photonicfusion/PhotoniClock/Documentation/html/images/display.png

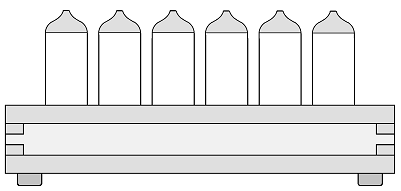
Documentation/html/images/display.png
