photonicfusion/PhotoniClock/Documentation/html/images/PhotoniClock.png

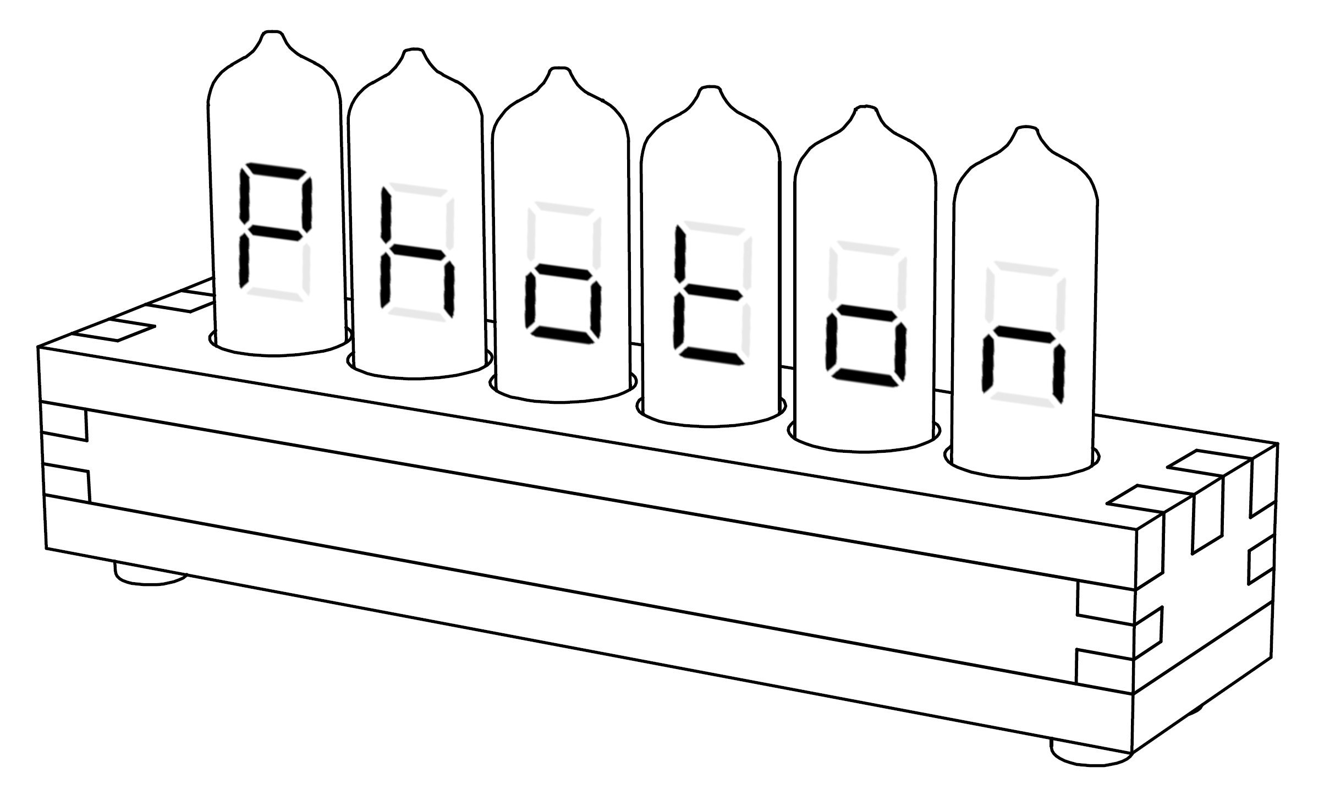
Documentation/html/images/PhotoniClock.png
