photonicfusion/PhotoniClock/Documentation/PhotoniClock User Manual.pdf

# PhotoniClock User Manual


## Last Revised: 25 September 2018

# Table of Contents

1. Introducon
2. Features
3. Specificaons
4. Safety
5. Background
6. Operaon
6.1. Info Menu
6.2. Disable Display
6.3. Main Menu
6.4. Alarms
6.5. Display Brightness
6.6. Configuraon
6.7. Display Blanking
6.8. Set Time
6.9. Set Date
6.10. LED Effect
6.11. Music
6.12. Timer (Countdown)
7. Open-Source Hardware & Soware
7.1. Flashing Firmware
7.2. Custom Music
8. Revision History
9. Contact Informaon
10. Warranty

# INTRODUCTION

Congratulaons on choosing the PhotoniClock! It is a fusion of past and present, combining the elegance of a bygone era with the technology of today. We hope it finds a place in your life and piques the curiosity of all who encounter it.

Thank you,

The PhotonicFusion Team

# FEATURES

• Handcraed Padauk wood finished with a protecve natural oil.
• Accurate mekeeping via temperature-compensated crystal oscillator (TCXO). • RTC backup for +24hr power-loss me retenon (unlike your microwave).
• Three alarms with individual day of the week sengs.
• Configurable Date/Time formats and Power On/Off schedule.
• Ambient light sensing adapts display brightness to environment.
• Music database of 40+ songs.
• RGB LEDs provide colorful and unique lighng effects.
• Input voltage protecon from Over/Under/Reverse condions. • Includes standard FTDI header for programming via Arduino IDE. • Open-source soware and hardware.

# SPECIFICATIONS

Item | Specificaon
Input voltage range | +9V to +15V (*see note)
Typical input power | 4.2W
Under/Over-voltage protecon | ±32V
Over-current protecon | PTC Thermistor, 750mA trip current
Typical clock dri | Less than 10s per month
Operang temperature | 0°C to 50°C (32°F to 122°F)
Storage Temperature | -20°C to 60°C (-44°F to 140°F)

*Note: Use the provided power adapter or use a power supply rated for a current of at least 1A to ensure the PhotoniClock's over-current protecon mechanism can funcon properly.

# SAFETY

The PhotoniClock has basic protecon against over-current, over-voltage, and under-voltage condions, however care should be taken to prevent these condions from occurring. Be careful not to touch or short any exposed circuit while powered, as doing so may permanently damage the clock. Do not modify the circuit in any way. Use the provided power adapter or a power supply rated for a current of at least 1A to ensure the PhotoniClock's over-current protecon mechanism can funcon properly.

# BACKGROUND

The PhotoniClock ulizes Vacuum Fluorescent Display (VFD) tubes, a specialized type of vacuum tube developed throughout the early 1960s into the late 1980s designed specifically for alphanumeric indicaon. The VFD tubes selected for this clock are called IV-11. They are a medium-sized, discrete, seven-segment display manufactured originally for the USSR by the Reflector plant in Saratov, Russia from the 1980s unl 1993.

VFD tubes operate under the same principals of vacuum tubes. Each tube contains two very thin wires called filaments through which an electric current is passed. If you view the PhotoniClock in a dark environment and reduce the display brightness, you may see the two filaments faintly glowing. Each of the VFD tube's seven segments are electrically connected to a circuit which can toggle a high voltage on/off, +56V in this parcular design. When this high voltage is applied to a segment, negavely charged electrons emied from the filament are magnecally aracted towards the posively charged segment. Upon striking the segment, the electrons are absorbed by a phosphor coang which re-emits the energy in the form of visible light, specifically a characterisc blue-green light associated with VFDs.

# OPERATION

On the backside of the PhotoniClock is a combined rotary encoder and buon knob. This knob is the sole method of input for controlling the PhotoniClock. When the PhotoniClock first turns on, it enters Clock Mode (displaying the current me). The Info Menu and the Main Menu are only accessible when in Clock Mode. All menus eventually meout and return to Clock Mode. Sengs will not be modified if a meout occurs before compleon.

Time is presented in this documentaon using the format HH:MM:SS where HH=Hours, MM=Minutes, and SS=Seconds.

## INFO MENU

Access the Info Menu by pressing the knob when in Clock Mode. The menu hierarchy is shown below. Advance to subsequent menu items by pressing the knob again.

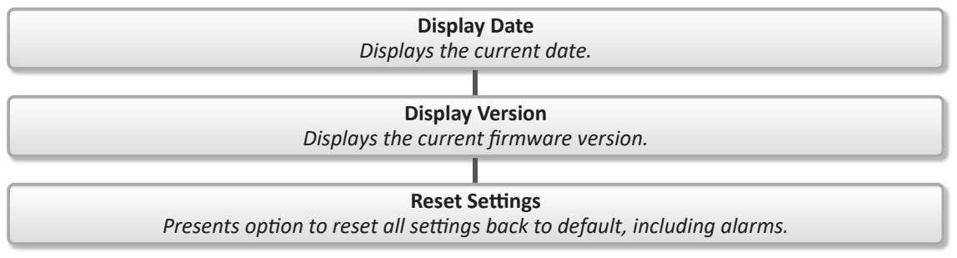
[picture p3: figure]
Display Date Displays the current date.; Display Version Displays the current firmware version.; Reset Sengs

Presents opon to reset all sengs back to default, including alarms.

## DISABLE DISPLAY

The display can be turned off by pressing and holding the knob for at least 3 seconds when entering the Info Menu. The display will remain off unl user input is received, an alarm occurs, or the display blanking Power-On me matches the current me.

## MAIN MENU

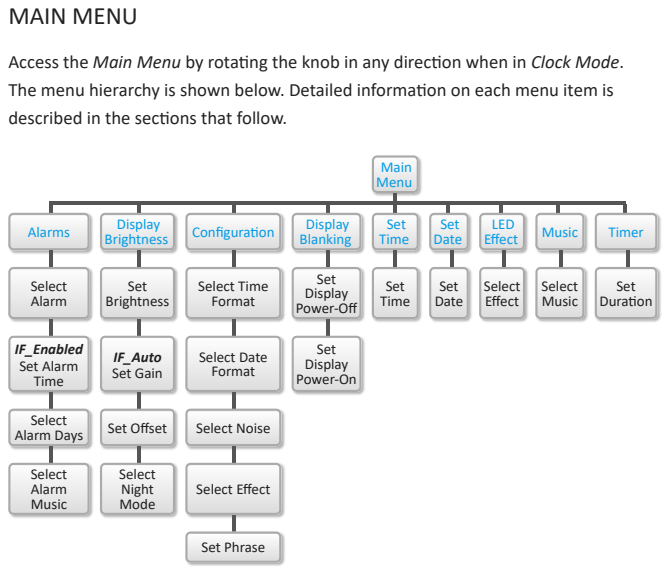
[picture p4: page 7]
Main Menu; Alarms; Display Brightness; Configuraon; Display Blanking; Set Time; Set Date; LED; Effect; Music; Timer; Select Alarm; Set Brightness; Select Time Format; Set Display Power-Off; Select Effect; Select Music; Set Duraon; IF_Enabled Set Alarm Time; IF_Auto Set Gain; Select Date Format; Set Display Power-On; Select Alarm Days; Set Offset; Select Noise; Select Alarm Music; Select Night Mode; Set Phrase

Access the Main Menu by rotang the knob in any direcon when in Clock Mode.
The menu hierarchy is shown below. Detailed informaon on each menu item is
described in the secons that follow.

## ALARMS

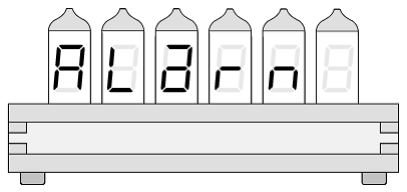
[picture p5: figure]

The PhotoniClock features three individual alarms. Each alarm may be set for a specific me and day(s) of the week for which it shall be acve. The decimal of the lemost VFD tube indicates whether an alarm is armed within the next 24 hours. If an alarm is armed, the decimal will be illuminated.

When an alarm me and day matches the current me and day, an alarm event will occur. An alarm event will cause the display to turn on (if it was previously off) and the alarm music selecon to sound. The alarm will sound for at least 2 minutes or unl interrupted. Any user input will interrupt the alarm.

Seng an alarm:

1. Select Alarm from the Main Menu.
2. Select one of the three alarms A1, A2, or A3 from the list. The current state of the alarm is displayed beside it as On if at least one day of the week is enabled, otherwise Off will be displayed.
3. Select Enable to connue configuring the alarm, or Dsable to disable the alarm and exit.
4. | Set | Set the me of day when the alarm should sound.
5. The day selecon menu will cycle through all days of the week. You may skip to any day by rotang the knob. Select a day to choose whether the alarm should be armed ( Enable ) or disarmed ( Dsable ) for that day. The menu will automacally advance to the next day aer a selecon is made.
Exit the menu by selecng ‑Done‑ | from the menu.
6. | Audio | Select the music that will play when the alarm sounds.

## DISPLAY BRIGHTNESS

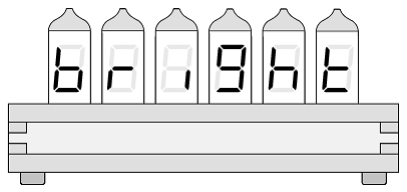
[picture p6: figure]

The PhotoniClock has 8 brightness levels for the display. In addion, there in an Auto Mode that will adjust the display brightness according to the ambient lighng condions. Aer selecng Auto Mode, there in an opon to enable Night Mode which will use minimum display brightness and turn off the LEDs when dark ambient condions are present. This provides an acceptable brightness level to avoid being bothersome at night.

Seng the display brightness:

1. Select Bright | from the Main Menu.
2. Select one of the 8 brightness sengs or select | Auto | to enable automac
brightness. If Auto Mode is selected, follow the remaining steps.
3. | Gain | Select the sensor gain. This value adjusts the sensivity of the
light sensor.
4. Offset Select the sensor offset. This value adjusts the minimum value measured by the light sensor.
5. | Night | Select whether to enable ( Enable ) or disable ( Dsable )
Night Mode. When enabled and dark ambient condions are present, minimum display brightness will be used and the LEDs will be disabled.

## CONFIGURATION

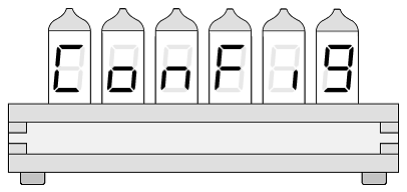
[picture p7: figure]

The PhotoniClock is customizable and can be configured to user preference. Configuraon sengs include me and date format, knob noise generaon, display effects, and custom phrase.

Configuring the PhotoniClock:

1. Select Config from the Main Menu.
2. | Hour | Select the hour format to be 12-hour ( 12 hr | ) or 24-hour
( 24 hr | ) mode.
3. | Date | Select the date format to be Y-M-D ( Y‑M‑D | ), M-D-Y ( M‑D‑Y | ),
or D-M-Y ( D‑M‑Y | ) where D=Day, M=Month, and Y=Year.
4. | Noise | Select whether an audible blip is enabled ( Enable ) or
disabled ( Dsable ) when the rotary encoder knob is turned.
5. Effect Select whether an effect should be displayed during normal clock display. Opons include:
• None No effect will be displayed.
• Spiral A spiral effect will be displayed when the seconds reach 0. • Date The current date will be displayed when the seconds reach 30. • Phrase The user configured phrase will be displayed when the seconds reach 30.
6. Phrase Input a custom phrase to display during alarms and display
| effects.

## DISPLAY BLANKING

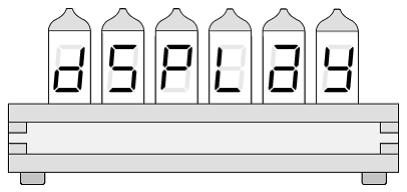
[picture p8: figure]

The PhotoniClock includes a display blanking feature which allows for scheduled mes when the display should turn off/on. This feature is useful if you want to turn off the clock at night (alternavely see Night Mode), or prolong the lifespan of the VFD tubes.

Seng the display blanking schedule:

1. Select Dsplay | from the Main Menu.
2. | P-Off | Input the me in HH:MM when the display should power-off.
3. | P-On | Input the me in HH:MM when the display should power-on.

Disable display blanking:

To disable display blanking, simply set the P-Off and P-On mes to be equal. This prevents display blanking from occurring.

## SET TIME

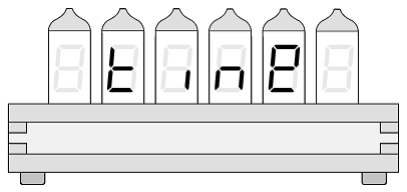
[picture p9: figure]

The PhotoniClock ulizes an RTC with a temperature-compensated crystal oscillator (TCXO). This parcular RTC has a very low clock dri, specified less than 10s per month. In addion, an on-board supercapacitor maintains RTC me and date during a power-loss event for over 24 hours.

Seng the me:

1. Select | Time | from the Main Menu.
2. | Time | Input the me in HH:MM:SS to set the clock.
3. | Cycle | If the Hour Format is configured to 12-hour mode, there will be
an addional selecon asking for current cycle. Choose between AM
( | AM | ) and PM ( | PM | ). The decimal of the rightmost VFD tube indicates
the current cycle. It will illuminate when the cycle is PM.

## SET DATE

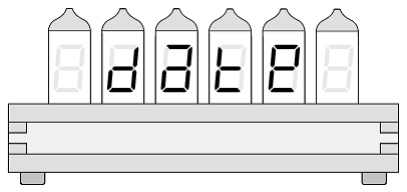
[picture p10: figure]

The PhotoniClock RTC automacally adjusts for leap years and accepts dates from 01-January-2000, to 31-December-2099.

Seng the date:

1. Select | Date | from the Main Menu.
2. | Date | Input the date to set the clock. The format used will be Y-M-D,
M-D-Y, or D-M-Y where D=Day, M=Month, and Y=Year depending on which Date Format is configured.

## LED EFFECT

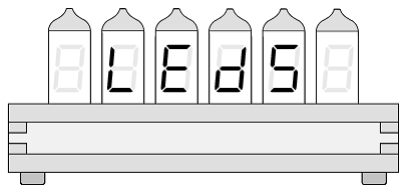
[picture p11: figure]

Beneath each VFD tube is an RGB LED. This array of LEDs can be configured to display effects listed in the descripon below. LED brightness is automacally adjusted to match the display brightness. In the event that Night Mode is triggered, the LEDs will be disabled.

Seng the LED effect:

1. Select | LEDs | from the Main Menu.
2. Effect Select the LED effect desired. Opons include: • Static Stac color choice.
• Pulse | Slow pulsing color choice.
• Fire | Fire effect of color choice.
• 1982 | Knight Rider effect of color choice.
• Pong | Color-changing bounce.
• Fade | Slow color-changing transions.
• Rainbo LEDs cycle through hue in unison.
• CShift LEDs cycle through hue in sequence.
• Ghost | Slow color orbs.
• Drops | Colors drop and combine every second.
• Digit | Hours, Minutes, Seconds translate to colors.
• Tetris Colors "fall" and collect.
• Cycle Cycle through all effects except Stac and Disable. • Dsable No effect will be displayed.

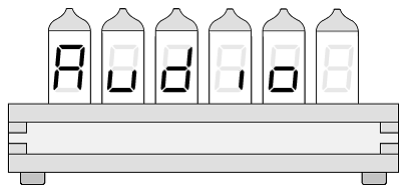
[picture p12: figure]

Entries 00-24
00 Alarm, Slow Beep
01 Alarm, Fast Beep
02 Ave_Maria
03 Bach_Prelude
04 Back_To_The_Future_Theme 05 Cave_Story_Moonsong
06 Fantaisie_Impromptu
07 Far_Off_Promise
08 Fortude
09 G&W_Gallery_2_Parachute 10 Game_of_Thrones
11 God_Save_The_Queen
12 Hall_of_the_Mountain_King 13 Harry_Poer_Hedwigs_Theme 14 He_is_a_pirate
15 Jurassic_Park_Theme
16 Kalinka
17 Katyusha

## MUSIC (AUDIO)

The PhotoniClock features two miniature transducers capable of square-wave generaon. Included in an on-board EEPROM is a library of music listed in the descripon below. Cycle through the music library to experience a retro interpretaon of iconic and modern songs. Users may oponally upload their own music following the procedure documented in secon Custom Music.

Browsing the music library:

1. Select Audio | from the Main Menu.
2. | Audio | Select the music for Alarm/Countdown events. Music list:
| | Entries 25+ 25 Morrisons_Jig 26 Mortal_Kombat_Theme 27 PacMan_Intro 28 Pallet_Town 29 Pokemon_Bale 30 Portal_Halls_of_Science 31 Portal_Sll_Alive 32 Song_of_Storms 33 Sonic_the_Hedgehog 34 SquareWave 35 Super_Mario_3_Overworld_2 36 Super_Mario_Bros_Overworld 37 Tanzunite 38 Tetris_A_Theme 39 The_Star_Spangled_Banner 40 Undertale_Spider_Dance 41 Under_the_Sea
| | 42

Entries 00-24
18 Kirby_Gourmet_Race
19 Knight_Rider
20 Legend_of_Zelda_Overworld 21 Stone_Tower_Temple
22 Marriage_D_Amour
23 Metroid_Kraids_Hideout
24 Mission_Impossible_Theme

Entries 25+
43
44
45
46
47
48
49

## TIMER (COUNTDOWN)

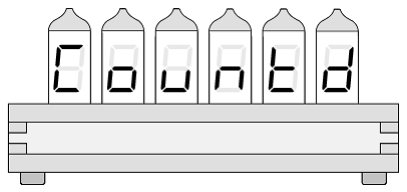
[picture p13: figure]

The PhotoniClock includes a mer feature with a configurable countdown duraon up to 1 day. Use the mer to easily set a single-use alarm for reminders, ming, and cases where a periodic alarm isn't needed. When the mer countdown reaches 0, an alarm will sound for at least 2 minutes or unl interrupted.

Seng the mer:

1. Select Countd | from the Main Menu.
2. | Set | Input the duraon in HH:MM:SS to set the mer.

# OPEN-SOURCE HARDWARE & SOFTWARE

The PhotoniClock project is open-source and available on GitHub from the following link:

hps://github.com/photonicfusion/photoniclock

## FLASHING FIRMWARE

To flash firmware to the PhotoniClock, follow the procedure below.

1. Download the latest firmware and ulies from GitHub.
2. Use the provided Makefile or Arduino IDE to compile the source to binary.
3. Use the provided python script PhotoniClock/Ulies/FlashProducon.py or Arduino IDE to upload the binary to the PhotoniClock using an FTDI cable.

## CUSTOM MUSIC

Custom music can be added to the PhotoniClock. Follow the procedure below.

1. Download the latest firmware and ulies from GitHub.
2. Install Python and the required modules (run PhotoniClock/Ulies/FlashProducon.py to determine missing modules).
3. Prepare music in MIDI format. For best results, choose MIDI files with few channels and note/rest duraons no smaller than triplet sixteenth. Place MIDI files into the PhotoniClock/Ulies/MIDI directory.
4. Follow the steps provided in secon Flashing Firmware and use "-e" flag with PhotoniClock/Ulies/FlashProducon.py to invoke EEPROM upload.

# REVISION HISTORY

Date | Descripon
30 August 2018 | Inial Release
25 September 2018 | Updated Music list. Updated URLs.

# CONTACT INFORMATION

If you have a warranty claim or need support, please contact us at: support@photonicfusion.io

The PhotoniClock and accessories can be purchased at hps://photonicfusion.io

# WARRANTY

The PhotoniClock is warranted to be free from defects in materials and workmanship for a period of one year from the date of purchase. If within the warranty period your unit should become inoperave from such defects, the unit will be repaired or replaced at the opon of PhotonicFusion. This warranty covers normal use and does not cover damage which occurs in shipment or failure which results from alteraon, tampering, hacking, accident, misuse, abuse, neglect or improper maintenance.

Any implied warranes, including but not limited to implied warranes of merchantability and fitness for a purpose, are limited to the express warranty. PhotonicFusion shall not be liable for loss of use of the unit or other incidental or consequenal damages, expenses, or economic loss, or for any claim or claims for such damage, expenses or economic loss. A purchase receipt or other proof of original purchase date will be required before warranty repairs or replacement will be rendered.
