photonicfusion/PhotoniClock/Schematic/PhotoniClock.PDF

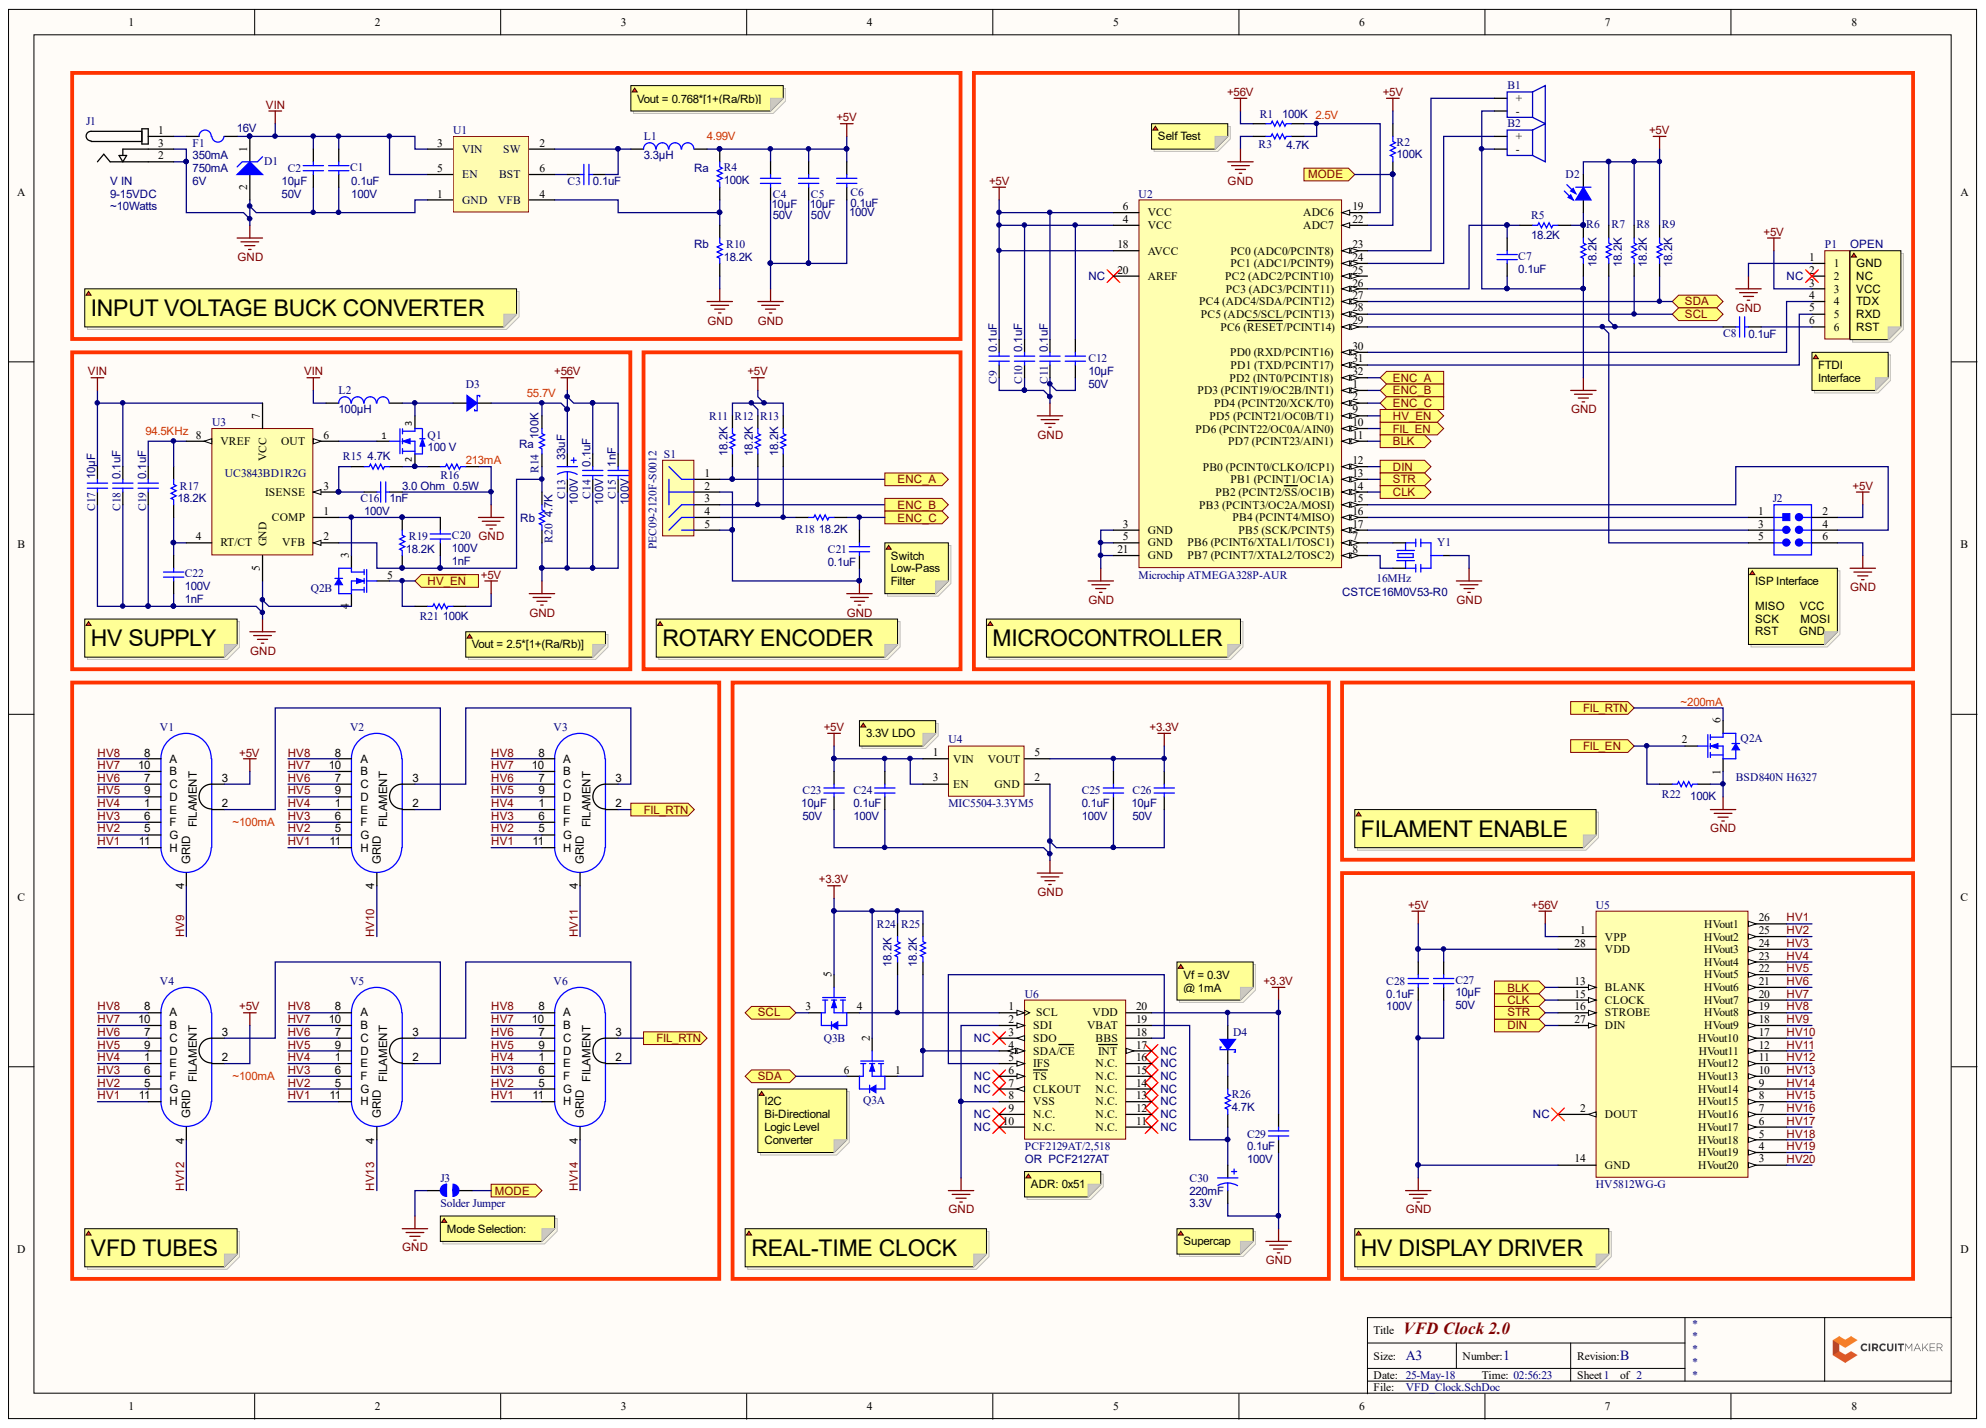
[picture p14: page 1]

INPUT VOLTAGE BUCK CONVERTER

VDD 28 | HV3

C27 | BLANK 13 | HV4

VFD Clock 2.0 Title | * * * * *

Size: A3 | Number: 1 | Revision: B

Date: 25-May-18 Time: 02:56:23 | | Sheet 1 of 2

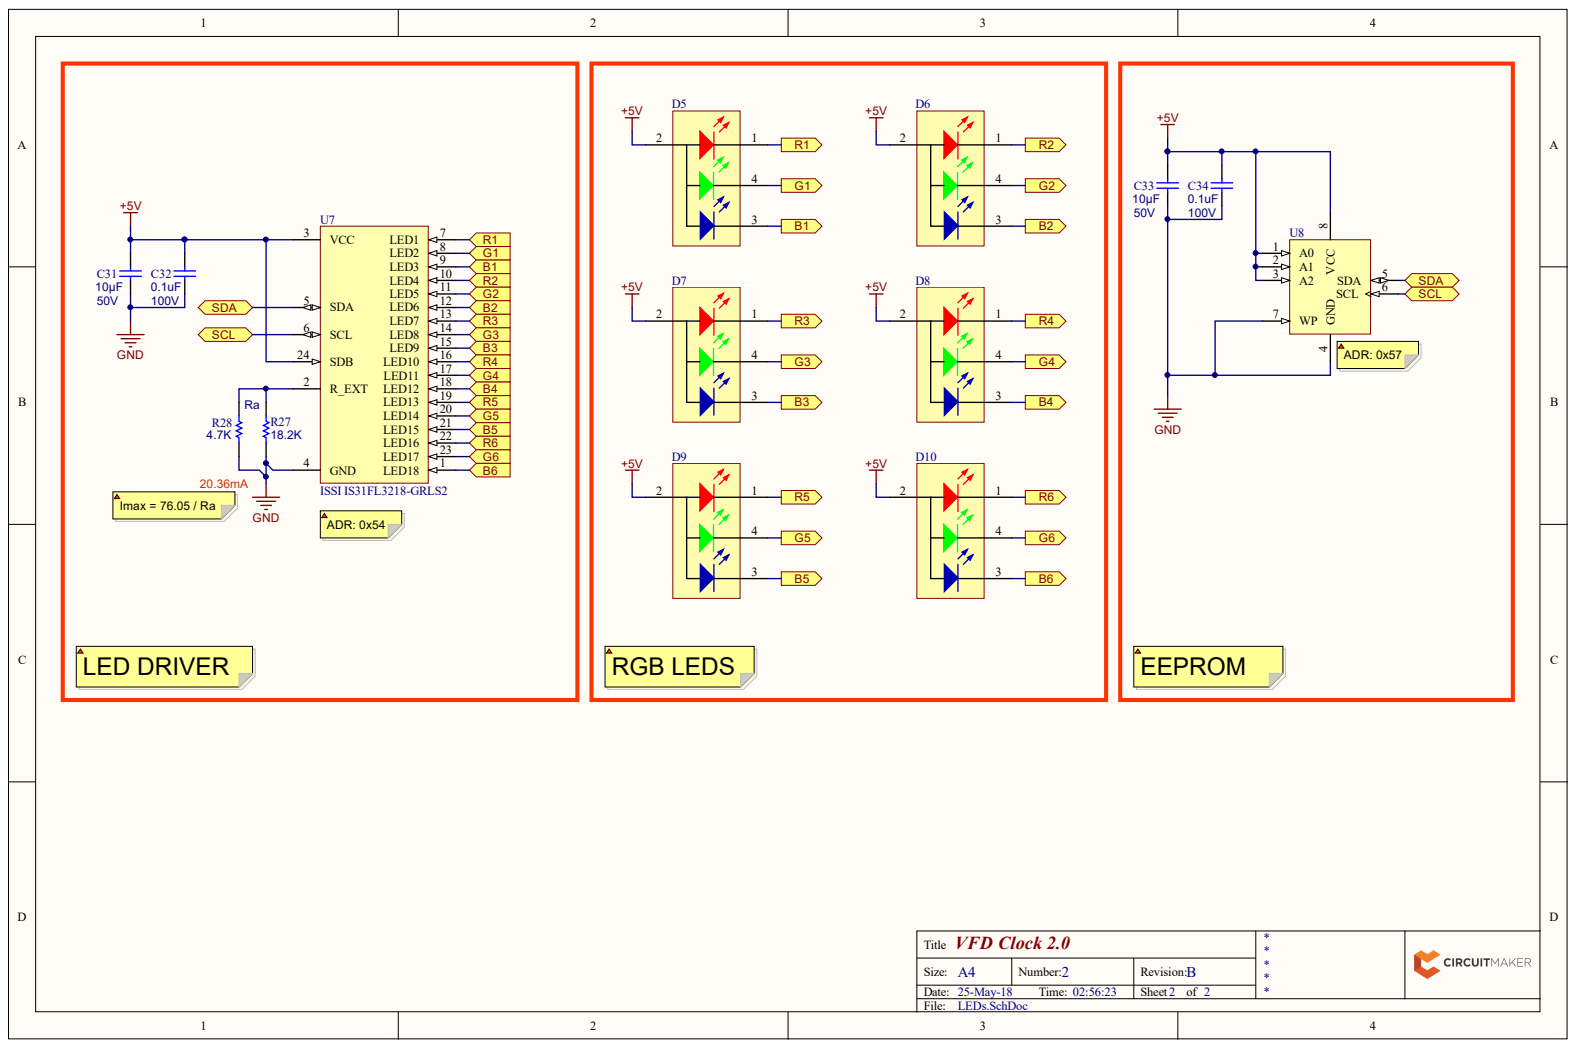
[picture p15: page 2]

VFD Clock 2. | **** *

A 4 | Numbe r : | R evision: B

D ate : 25-May-18 Time : 02:56:23 | | She e t 2 of 2
File : LEDs. S chDoc

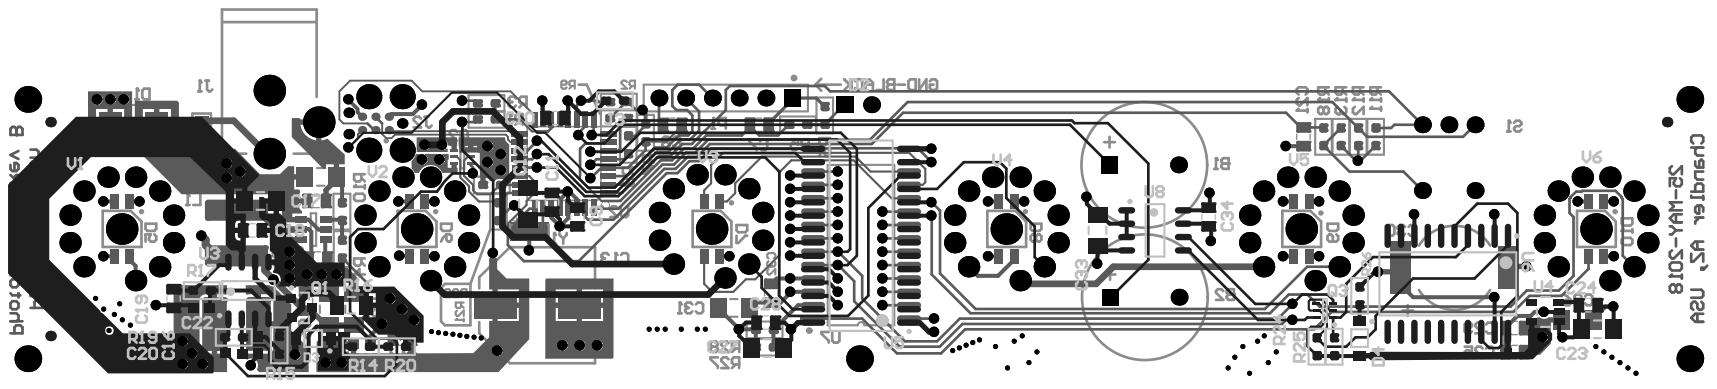
[picture p16: page 3]
